Marbslab/Open-source-Geiger-counter/Geiger counter schematics.pdf

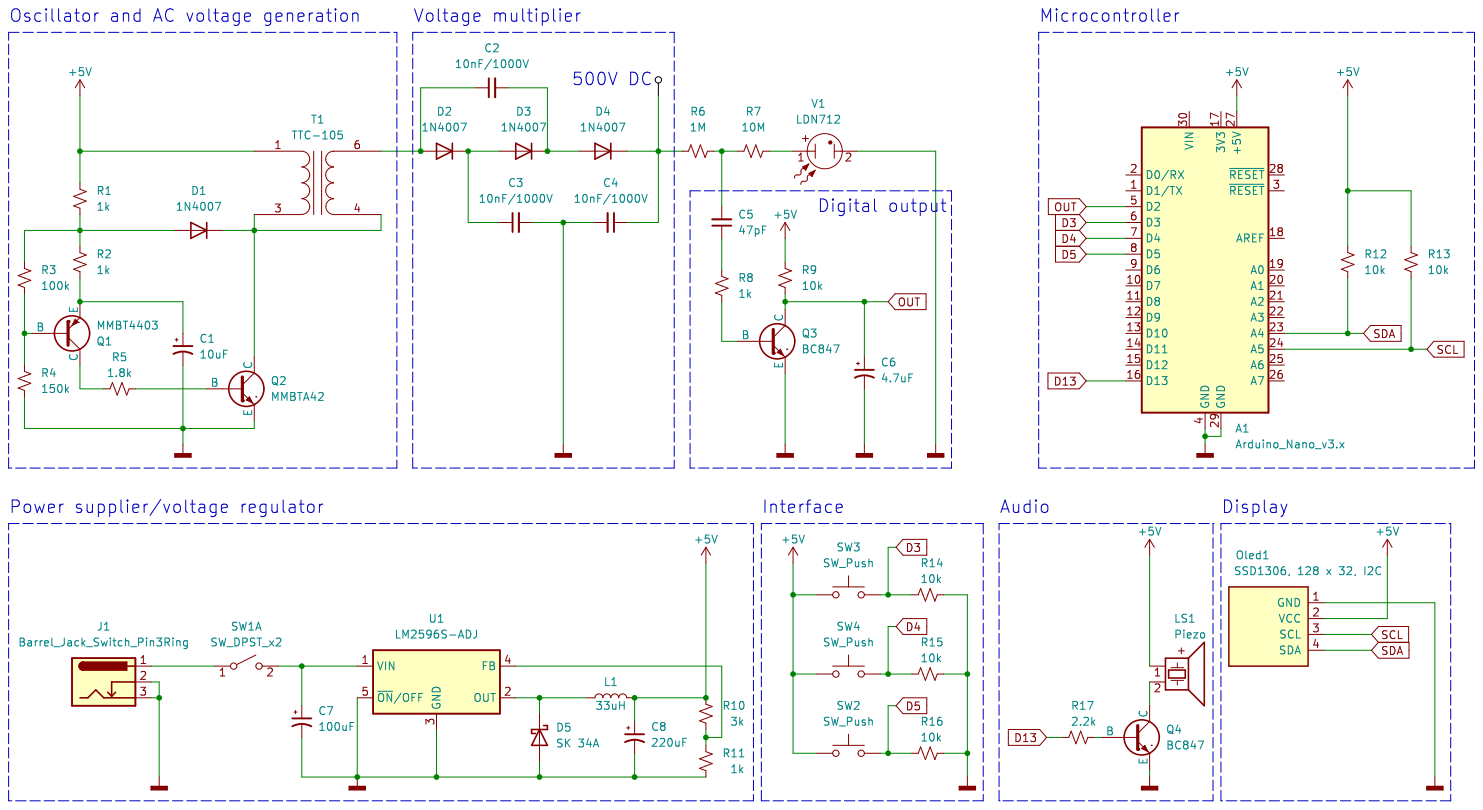
[picture p1: page 1]
